fabiobaltieri/nrf-ethernet/hardware/nrf-ethernet.brd

## EAGLE design hardware/nrf-ethernet.brd (2013-04-16)

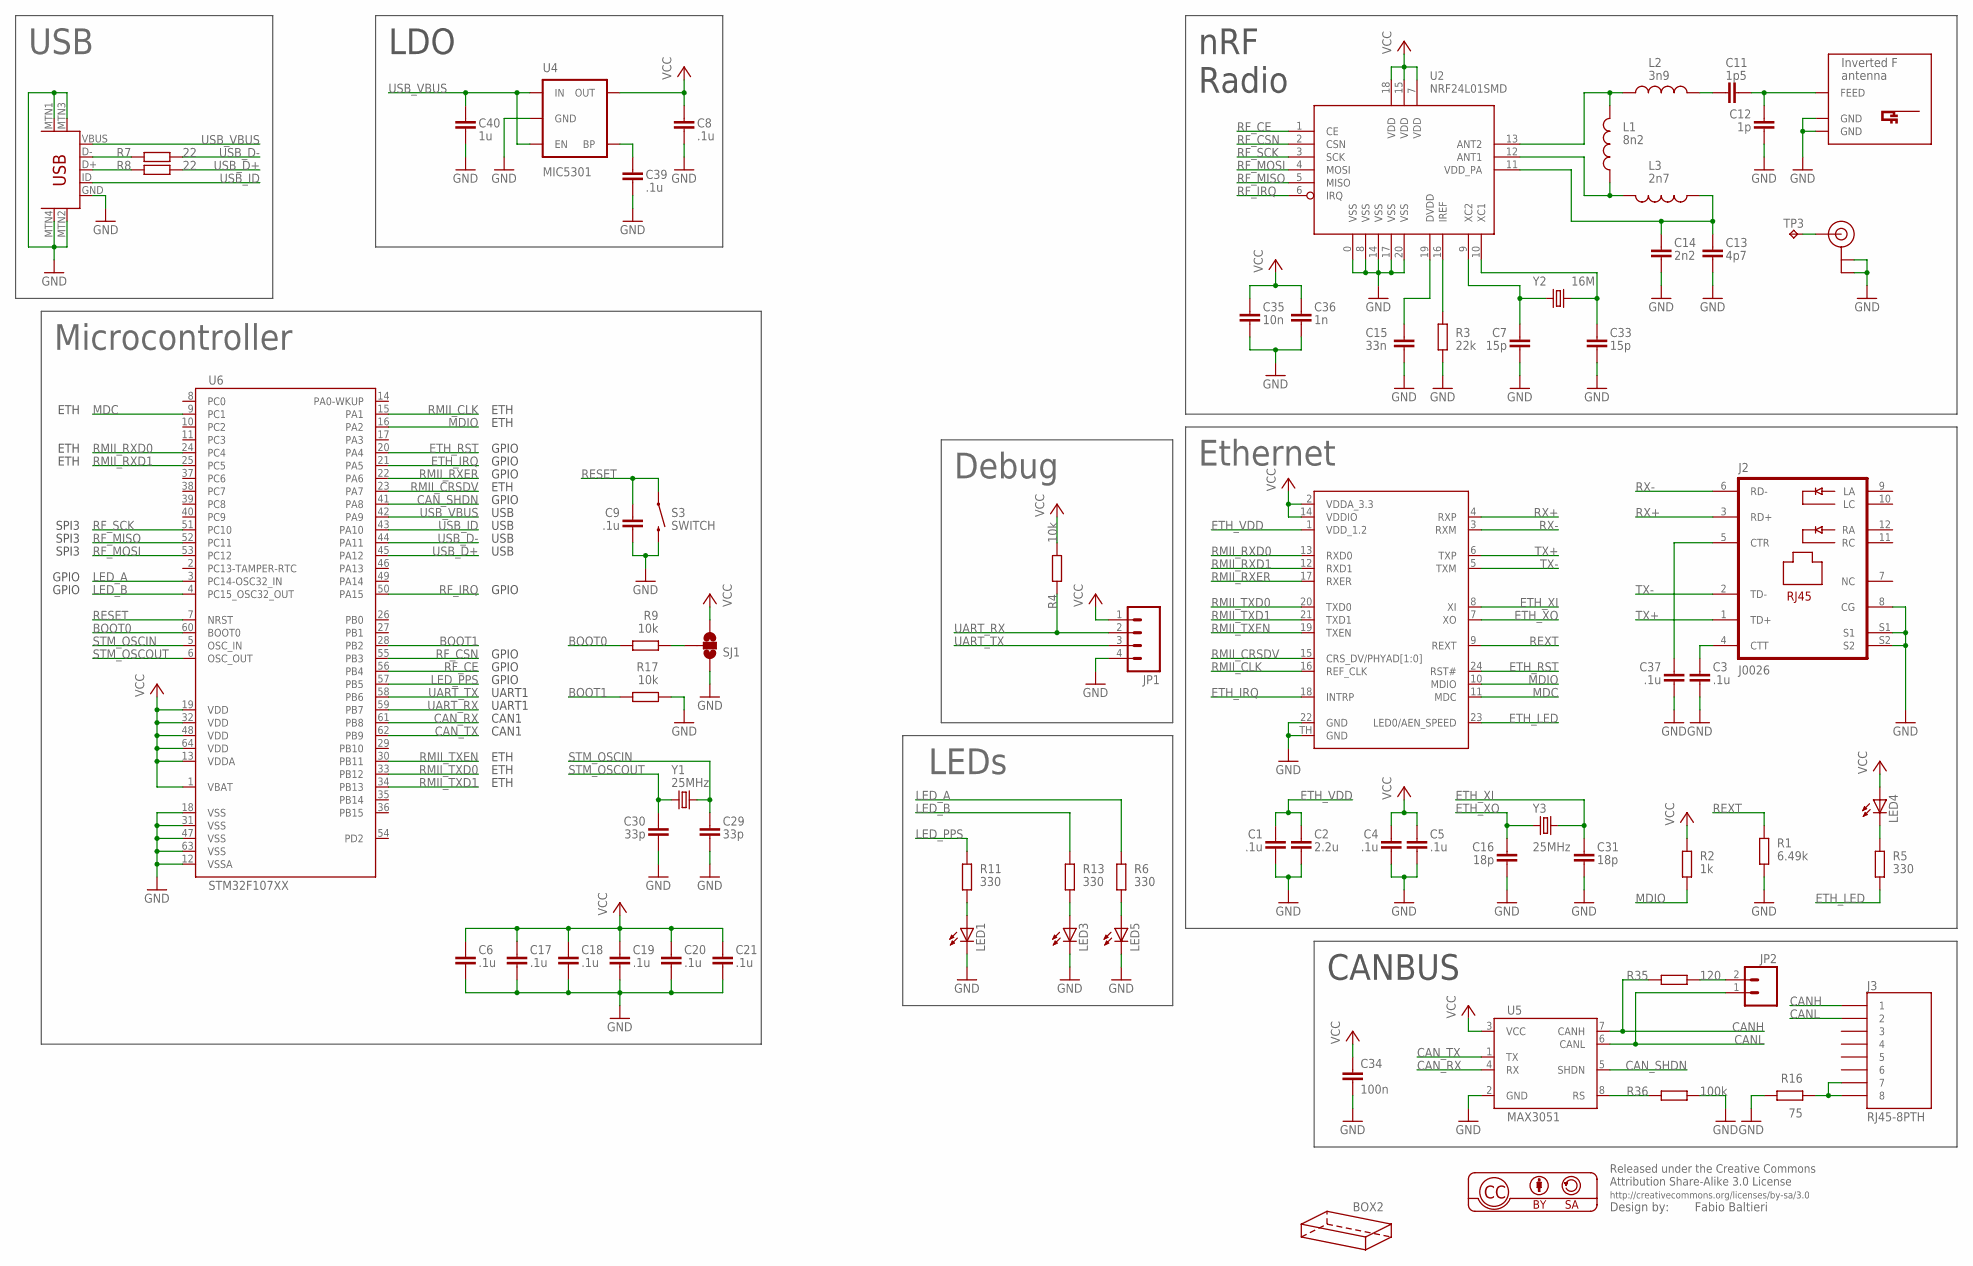
[picture p1: schematic nrf-ethernet.sch]

Parts:
BOX2: HAMMOND-BOX-K; 1551K
C1, C3, C4, C5, C6, C8, C9, C17, C18, C19, C20, C21, C37, C39: .1u; C0603
C2: 2.2u; C0603
C7, C33: 15p; C0603
C11: 1p5; C0603
C12: 1p; C0603
C13: 4p7; C0603
C14: 2n2; C0603
C15: 33n; C0603
C16, C31: 18p; C0603
C29, C30: 33p; C0603
C34: 100n; C0603
C35: 10n; C0603
C36: 1n; C0603
C40: 1u; C0603
J2: J0026; PJ-J0
J3: RJ45-8PTH; RJ45-8
JP1: M04PTH; 1X04
JP2: M02PTH; 1X02
L1: 8n2; 0603
L2: 3n9; 0603
L3: 2n7; 0603
LED1, LED3, LED4, LED5: LEDCHIPLED_0805; CHIPLED_0805
R1: 6.49k; R0603
R2: 1k; R0603
R3: 22k; R0603
R4, R9, R17: 10k; R0603
R5, R6, R11, R13: 330; R0603
R7, R8: 22; R0603
R16: 75; R0805
R35: 120; R0805
R36: 100k; R0603
S3: SWITCH; TACTILE_SWITCH_SMD
SJ1: SOLDERJUMPER_2WAYS; SJ_3
TP3: TPTP08SQ; TP08SQ
U1: KSZ8081RNA; QFN24
U2: NRF24L01SMD; QFN20
U4: MIC5301; SOT23-5
U5: MAX3051; SO08
U6: STM32F107XX; LQFP64
U$4: USB-MINIB-5PIN; USB-MINIB
U$5: INVERTED_F_ANTENNA-2; DN007-2
U$6: U.FL
Y1, Y3: 25MHz; CRYSTAL-SMD-5X3
Y2: 16M; CRYSTAL-SMD-5X3

Connections:
BOOT0: R9.2, U6.60 (BOOT0)
BOOT1: R17.2, U6.28 (PB2)
CANH: J3.1, R35.1, U5.7 (CANH)
CANL: J3.2, JP2.1, U5.6 (CANL)
CAN_RX: U5.4 (RX), U6.61 (PB8)
CAN_SHDN: U5.5 (SHDN), U6.41 (PA8)
CAN_TX: U5.1 (TX), U6.62 (PB9)
ETH_IRQ: U1.18 (INTRP), U6.21 (PA5)
ETH_LED: R5.1, U1.23 (LED0/AEN_SPEED)
ETH_RST: U1.24 (RST#), U6.20 (PA4)
ETH_VDD: C1.1, C2.1, U1.1 (VDD_1.2)
ETH_XI: C31.1, U1.8 (XI), Y3.3 (2)
ETH_XO: C16.1, U1.7 (XO), Y3.1
GND: C1.2, C2.2, C3.2, C4.2, C5.2, C6.2, C7.2, C8.2, C9.2, C12.2, C13.2, C14.2, C15.2, C16.2, C17.2, C18.2, C19.2, C20.2, C21.2, C29.2, C30.2, C31.2, C33.2, C34.2, C35.2, C36.2, C37.2, C39.2, C40.2, J2.8 (CG), J2.S1, J2.S2, JP1.4, LED1.C, LED3.C, LED5.C, R1.1, R3.2, R16.1, R17.1, R36.2, S3.3 (2), SJ1.1, U1.22 (GND), U1.TH (GND), U2.0 (VSS), U2.8 (VSS), U2.14 (VSS), U2.17 (VSS), U2.20 (VSS), U4.2 (GND), U5.2 (GND), U6.12 (VSSA), U6.18 (VSS), U6.31 (VSS), U6.47 (VSS), U6.63 (VSS), U$4.GND, U$4.MTN1 (MTN2), U$4.MTN2 (MTN3), U$4.MTN3 (MTN1), U$4.MTN4, U$5.GND, U$5.GND@1 (GND), U$6.P$1 (GND), U$6.P$2 (GND)
LED_A: R6.2, U6.3 (PC14-OSC32_IN)
LED_B: R13.2, U6.4 (PC15_OSC32_OUT)
LED_PPS: R11.2, U6.57 (PB5)
MDC: U1.11 (MDC), U6.9 (PC1)
MDIO: R2.1, U1.10 (MDIO), U6.16 (PA2)
unnamed: LED4.C, R5.2
unnamed: LED1.A, R11.1
unnamed: L1.2, L3.2, U2.12 (ANT1)
unnamed: L1.1, L2.1, U2.13 (ANT2)
unnamed: LED3.A, R13.1
unnamed: C11.1, L2.2
unnamed: C33.1, U2.10 (XC1), Y2.3 (2)
unnamed: C7.1, U2.9 (XC2), Y2.1
unnamed: C3.1, J2.4 (CTT)
unnamed: C37.1, J2.5 (CTR)
unnamed: LED5.A, R6.1
unnamed: C11.2, C12.1, U$5.FEED
unnamed: C13.1, C14.1, L3.1, U2.11 (VDD_PA)
unnamed: C15.1, U2.19 (DVDD)
unnamed: R3.1, U2.16 (IREF)
unnamed: R9.1, SJ1.2
unnamed: TP3.TP, U$6.P$3 (SIGNAL)
unnamed: R7.1, U$4.D-
unnamed: R36.1, U5.8 (RS)
unnamed: R8.1, U$4.D+
unnamed: JP2.2, R35.2
unnamed: J3.7, J3.8, R16.2
unnamed: C39.1, U4.4 (BP)
RESET: C9.1, S3.1, U6.7 (NRST)
REXT: R1.2, U1.9 (REXT)
RF_CE: U2.1 (CE), U6.56 (PB4)
RF_CSN: U2.2 (CSN), U6.55 (PB3)
RF_IRQ: U2.6 (IRQ), U6.50 (PA15)
RF_MISO: U2.5 (MISO), U6.52 (PC11)
RF_MOSI: U2.4 (MOSI), U6.53 (PC12)
RF_SCK: U2.3 (SCK), U6.51 (PC10)
RMII_CLK: U1.16 (REF_CLK), U6.15 (PA1)
RMII_CRSDV: U1.15 (CRS_DV/PHYAD[1:0]), U6.23 (PA7)
RMII_RXD0: U1.13 (RXD0), U6.24 (PC4)
RMII_RXD1: U1.12 (RXD1), U6.25 (PC5)
RMII_RXER: U1.17 (RXER), U6.22 (PA6)
RMII_TXD0: U1.20 (TXD0), U6.33 (PB12)
RMII_TXD1: U1.21 (TXD1), U6.34 (PB13)
RMII_TXEN: U1.19 (TXEN), U6.30 (PB11)
RX+: J2.3 (RD+), U1.4 (RXP)
RX-: J2.6 (RD-), U1.3 (RXM)
STM_OSCIN: C29.1, U6.5 (OSC_IN), Y1.3 (2)
STM_OSCOUT: C30.1, U6.6 (OSC_OUT), Y1.1
TX+: J2.1 (TD+), U1.6 (TXP)
TX-: J2.2 (TD-), U1.5 (TXM)
UART_RX: JP1.2, R4.1, U6.59 (PB7)
UART_TX: JP1.3, U6.58 (PB6)
USB_D+: R8.2, U6.45 (PA12)
USB_D-: R7.2, U6.44 (PA11)
USB_ID: U6.43 (PA10), U$4.ID
USB_VBUS: C40.1, U4.1 (IN), U4.3 (EN), U6.42 (PA9), U$4.VBUS
VCC: C4.1, C5.1, C6.1, C8.1, C17.1, C18.1, C19.1, C20.1, C21.1, C34.1, C35.1, C36.1, JP1.1, LED4.A, R2.2, R4.2, SJ1.3, U1.2 (VDDA_3.3), U1.14 (VDDIO), U2.7 (VDD), U2.15 (VDD), U2.18 (VDD), U4.5 (OUT), U5.3 (VCC), U6.1 (VBAT), U6.13 (VDDA), U6.19 (VDD), U6.32 (VDD), U6.48 (VDD), U6.64 (VDD)

Notes on the sheet:
Ethernet
USB
Debug
CANBUS
nRF
Radio
LDO
LEDs
Microcontroller
GPIO
ETH
SPI3
CAN1
UART1

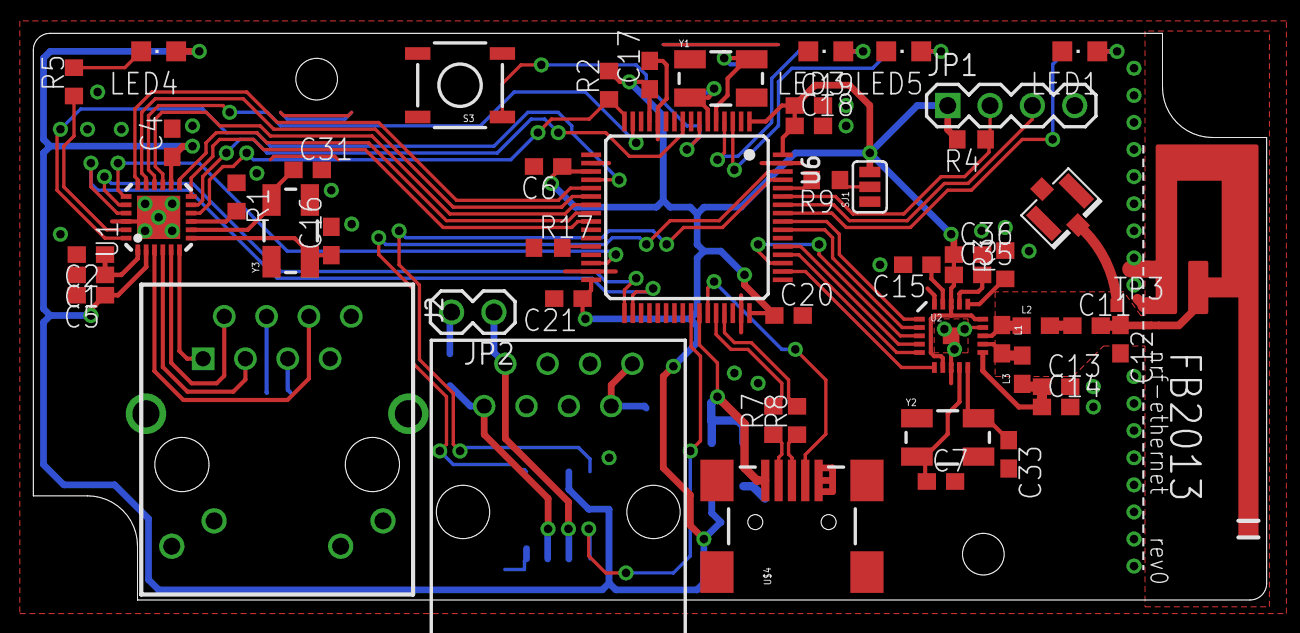
[picture p2: board nrf-ethernet.brd from above]

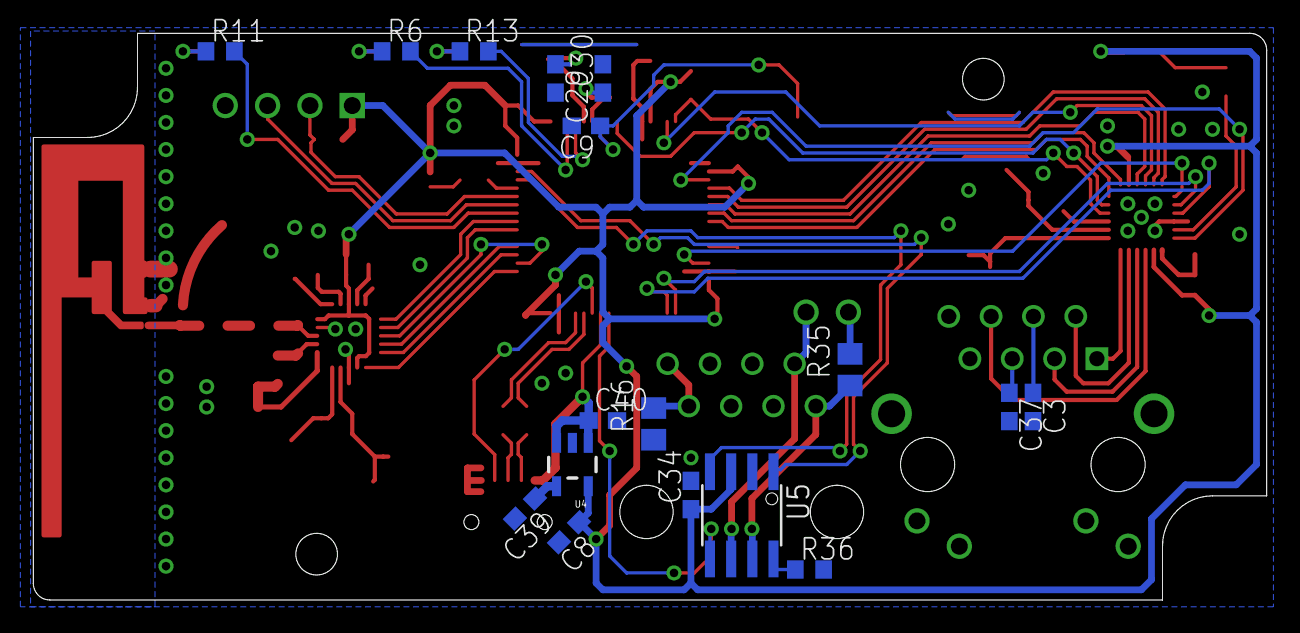
[picture p3: board nrf-ethernet.brd from below]

Board: 2 copper layers, 74.0 x 34.0 mm, 71 parts (17 on the bottom side), 71 nets.
