fabiobaltieri/nrf-ethernet/(commit log)

2013-02-19 value update
    [nrf-ethernet.brd, nrf-ethernet.sch]
2013-02-24 add silk and gnd vias
    [nrf-ethernet.brd]
2013-02-24 move measurement to meas layer
    [nrf-ethernet.brd]
2013-04-16 hw: fix some part number value
    [nrf-ethernet.brd, nrf-ethernet.sch]
2013-04-19 bl: new makefile borrowed from power-manager
2013-04-19 bl: change i/o and clock for nrf-eth board
2013-04-19 bl: rework bootloader bailout logic to timeout based
    [usbdfu.c]
2013-04-19 bl: leave_bootloader instead of reset
    [usbdfu.c]
2013-04-20 fw: set uart rate to 115200 bps
2013-04-20 fw: board: add some pr_ helper function
2013-04-21 fw: remap canbus pins
2013-04-21 hw: mark led colors in schematic
    [nrf-ethernet.sch]
2013-04-21 fw: clean LEDs defines
2013-04-21 fw: add STM32_MAC settings
2013-04-22 fw: console: rename threads to ps
2013-04-22 fw: add usb support and soft-reset via usb for comfy reprogramming
    [halconf.h, main.c]
2013-04-24 fw: add blink threads and API
2013-04-29 fw: enable external interrupt stubs
2013-04-29 fw: add nrf24l01p driver
2013-04-29 fw: enable lwip thread
2013-04-30 fw: board: set phy id, through it's not really used
2013-05-01 fw: use struct qualifier for threads
2013-06-22 debug: move print defines to USB device
2013-06-29 fw: fix json print when first entry is clean
    [data.c]
2013-06-30 fw: fix stale lock on table full
    [data.c]
2013-12-26 fw: add missing nrf_frames.h
    [nrf_frames.h]
