fabiobaltieri/nrf-ethernet/(notices)

Notices in the files:
bootloader/usbdfu.c:
This library is free software: you can redistribute it and/or modify
it under the terms of the GNU Lesser General Public License as published by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
firmware/lwipopts.h:
Copyright (c) 2001-2004 Swedish Institute of Computer Science.
All rights reserved.
parts and their libraries:
SparkFun-Connectors: Licensing: CC v3.0 Share-Alike You are welcome to use this library for commercial purposes.
balto: Released under the Creative Commons
balto: http://creativecommons.org/licenses/by-sa/3.0
